TomKeddie/prj-kicad-libs/README.md

# tom-kicad

This is just a collection of my stuff I use in kicad, no warranty, use at own risk.
