TomKeddie/prj-kicad-libs/footprints/3dmodels/KaihlSocket_1511-CONN-170206_ASM_ASM_3_ASM__ASM.STEP

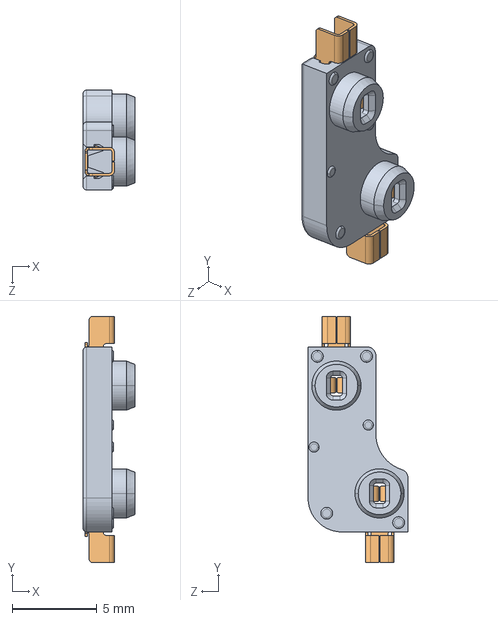
[picture p1: CAD file, 2021-04-25]
footprints/3dmodels/KaihlSocket_1511-CONN-170206_ASM_ASM_3_ASM__ASM.STEP
3.05 x 14.5 x 5.89 mm
BASE02_D6_18_18_1_1_1_1_2_1_1_2
CONN-011601_18_1_1_1_1_2_1_1_1 x 2
