TomKeddie/prj-kicad-libs/footprints/3dmodels/SMTSO-M3-10ET-PennEngineering-3D-05-29-2021.stp

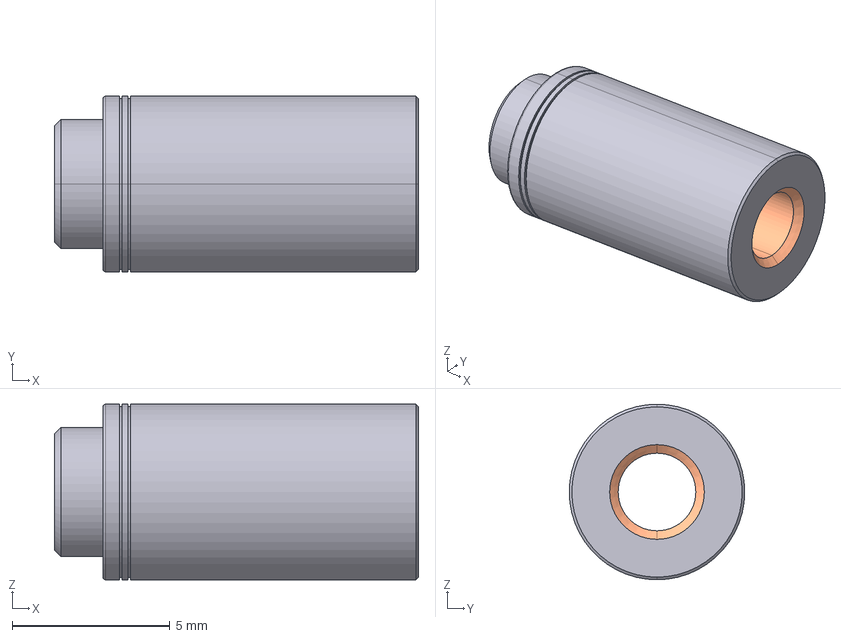
[picture p2: CAD file, 2021-05-30]
footprints/3dmodels/SMTSO-M3-10ET-PennEngineering-3D-05-29-2021.stp
11.5 x 5.56 x 5.56 mm
