TomKeddie/prj-kicad-libs/connectors/3d-models/FTSH-110-01-F-DV-K-TR--3DModel-STEP-56544.STEP

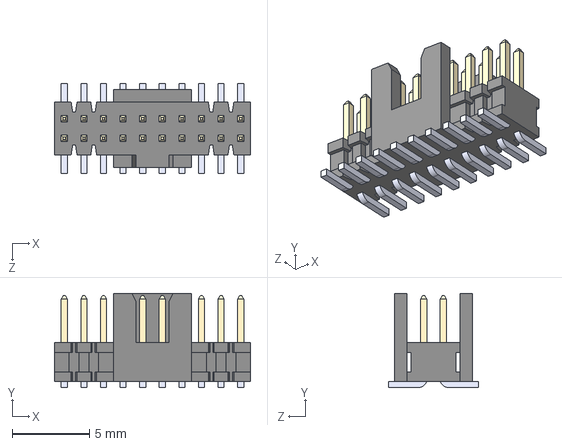
[picture p3: CAD file, 2022-05-18]
connectors/3d-models/FTSH-110-01-F-DV-K-TR--3DModel-STEP-56544.STEP
12.7 x 6.12 x 5.84 mm
