TomKeddie/prj-kicad-libs/footprints/3dmodels/1x1R4.step

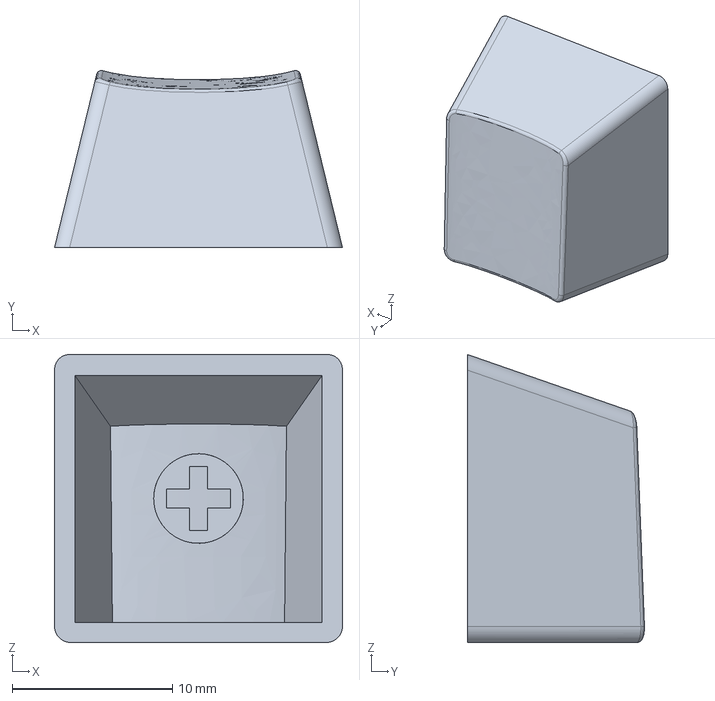
[picture p4: CAD file, 2021-04-25]
footprints/3dmodels/1x1R4.step
18.0 x 11.1 x 18.0 mm
