TomKeddie/prj-kicad-libs/footprints/3dmodels/mx_style_switch.stp

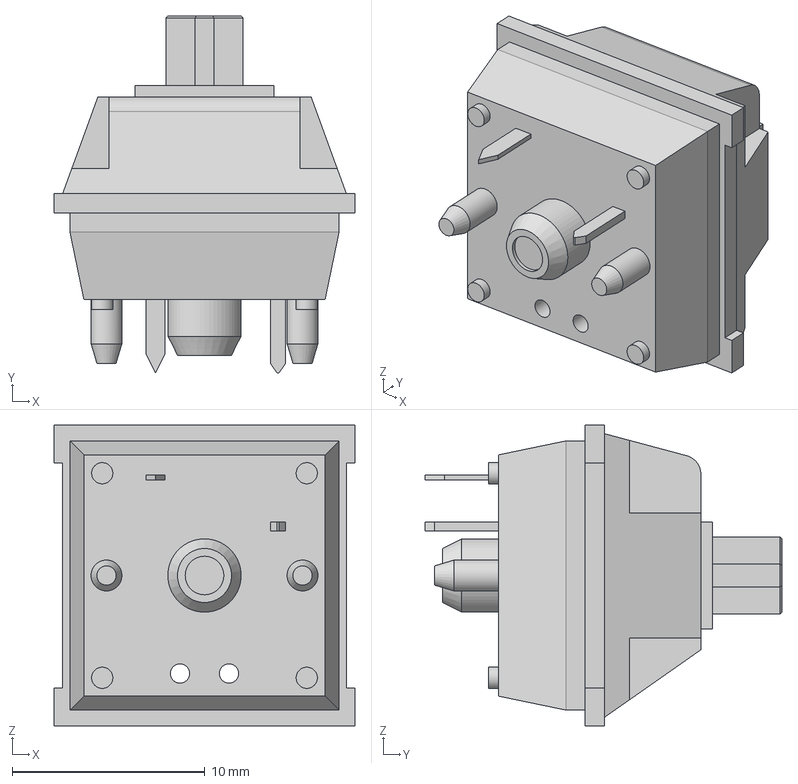
[picture p5: CAD file, 2021-04-21]
footprints/3dmodels/mx_style_switch.stp
15.6 x 18.5 x 15.6 mm
