TomKeddie/prj-kicad-libs/connectors/3d-models/pj-3200.stp

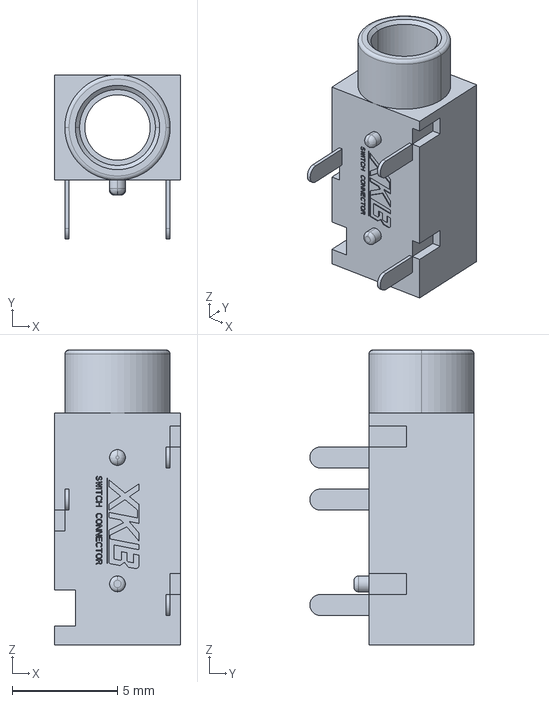
[picture p6: CAD file, 2022-05-16]
connectors/3d-models/pj-3200.stp
6.00 x 7.80 x 14.0 mm
