TomKeddie/prj-kicad-libs/footprints/3dmodels/FTSH-105-01-F-DV-K.stp

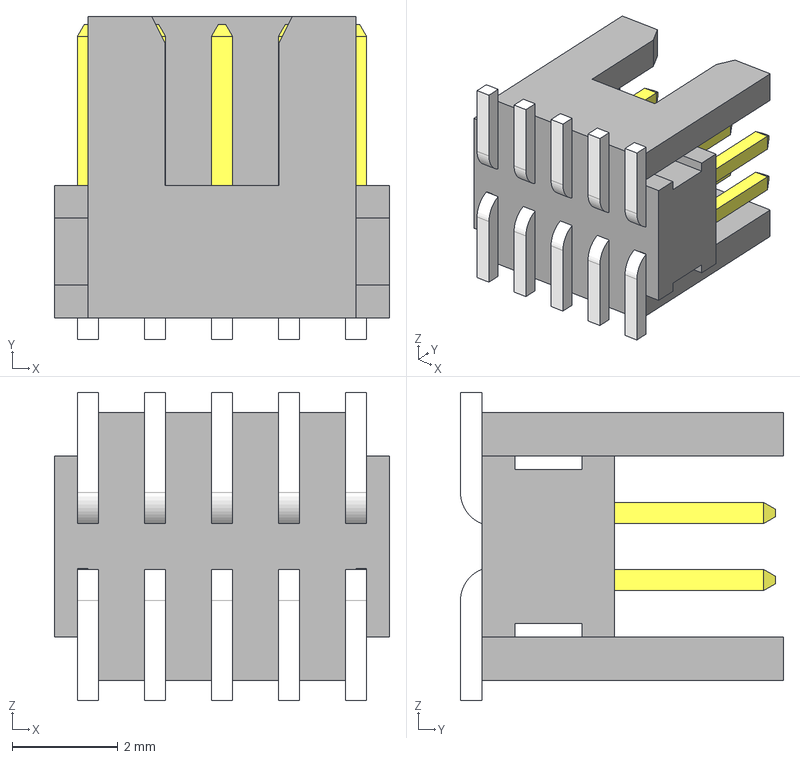
[picture p7: CAD file, 2021-03-10]
footprints/3dmodels/FTSH-105-01-F-DV-K.stp
6.35 x 6.12 x 5.84 mm
_FTSH-105-01-F-DV-K_body
_FTSH-105-01-F-DV-K_pins1
_FTSH-105-01-F-DV-K_pins2
