TomKeddie/prj-kicad-libs/footprints/3dmodels/FTSH-110-01-F-DV-K.stp

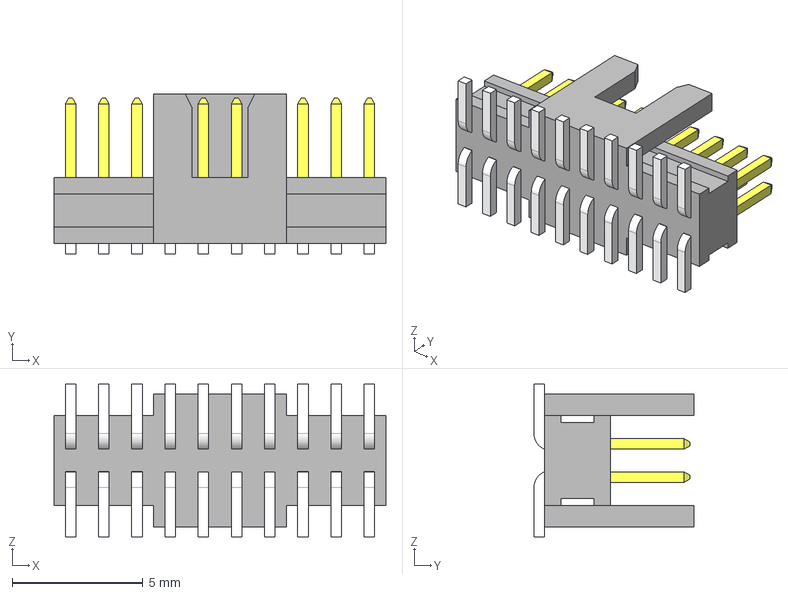
[picture p8: CAD file, 2021-03-10]
footprints/3dmodels/FTSH-110-01-F-DV-K.stp
12.7 x 6.12 x 5.84 mm
_FTSH-110-01-F-DV-K_body
_FTSH-110-01-F-DV-K_pins1
_FTSH-110-01-F-DV-K_pins2
