TomKeddie/prj-kicad-libs/connectors/3d-models/SSW-106-02-F-D-RA.stp

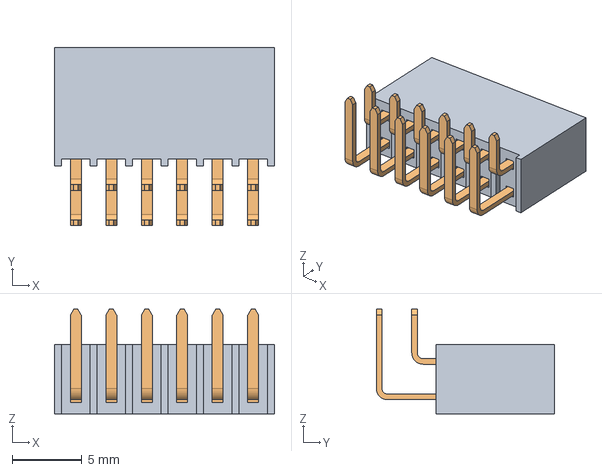
[picture p9: CAD file, 2021-12-23]
connectors/3d-models/SSW-106-02-F-D-RA.stp
15.7 x 12.8 x 7.48 mm
_T1SSW-106-02-F-D-RA
_P2SSW-106-02-F-D-RA
