TomKeddie/prj-kicad-libs/footprints/3dmodels/GT-USB-7010.step

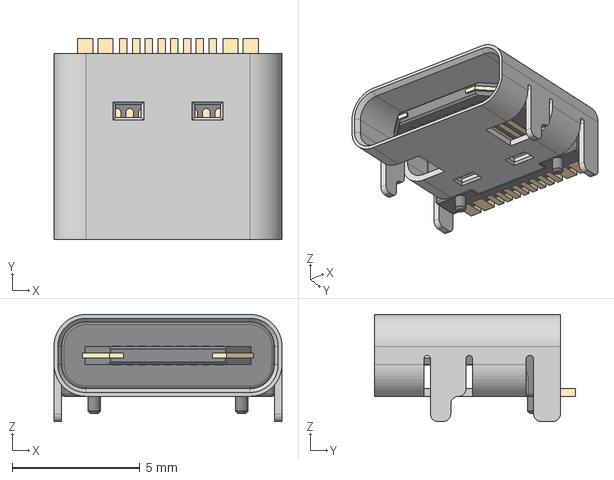
[picture p10: CAD file, 2020-12-16]
footprints/3dmodels/GT-USB-7010.step
8.94 x 7.90 x 4.20 mm
