TomKeddie/prj-kicad-libs/footprints/3dmodels/USB-A1HSW6--3DModel-STEP-56544.STEP

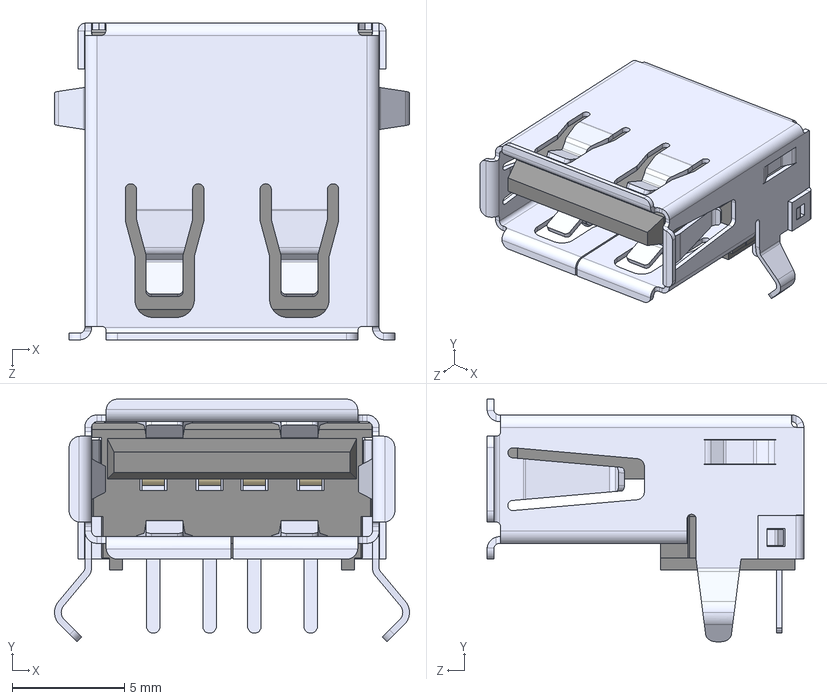
[picture p11: CAD file, 2020-09-19]
footprints/3dmodels/USB-A1HSW6--3DModel-STEP-56544.STEP
15.8 x 10.8 x 14.1 mm
