TomKeddie/prj-kicad-libs/footprints/3dmodels/CUI_DEVICES_UJ2-AV-1-TH.step

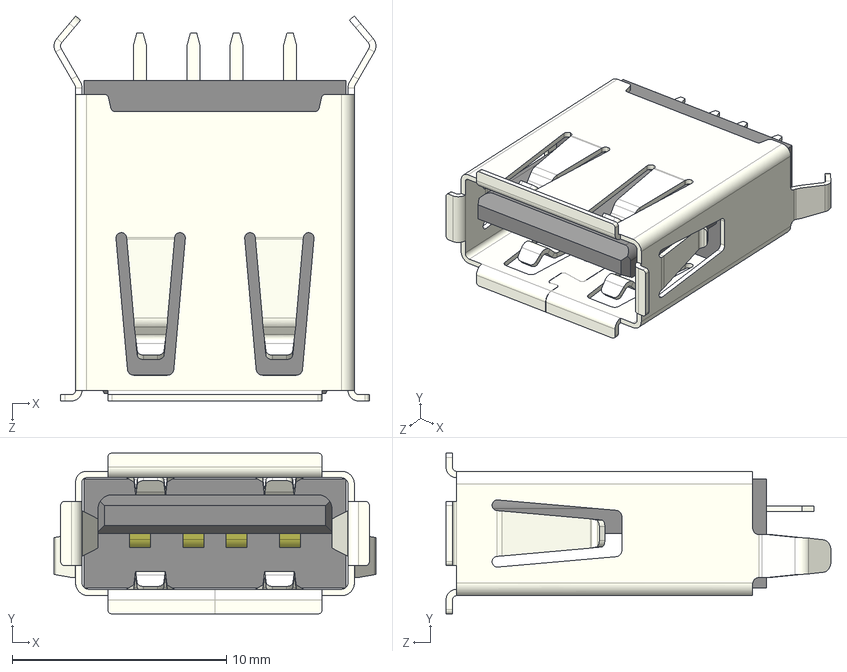
[picture p12: CAD file, 2020-09-19]
footprints/3dmodels/CUI_DEVICES_UJ2-AV-1-TH.step
15.0 x 7.50 x 18.0 mm
