TomKeddie/prj-kicad-libs/footprints/3dmodels/KMMX-BSMT35S-BTR_A.STEP

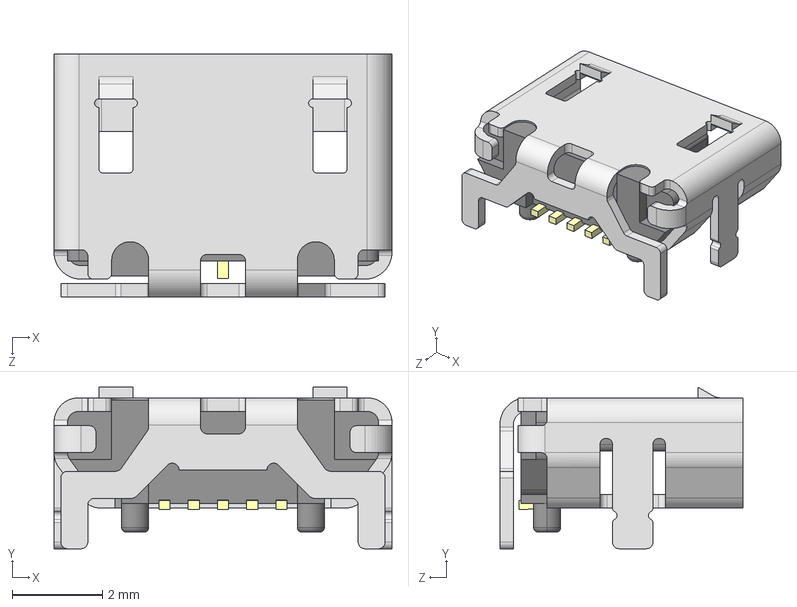
[picture p13: CAD file, 2020-09-19]
footprints/3dmodels/KMMX-BSMT35S-BTR_A.STEP
7.50 x 3.58 x 5.40 mm
