TomKeddie/prj-kicad-libs/footprints/3dmodels/mf-nsmf150.stp

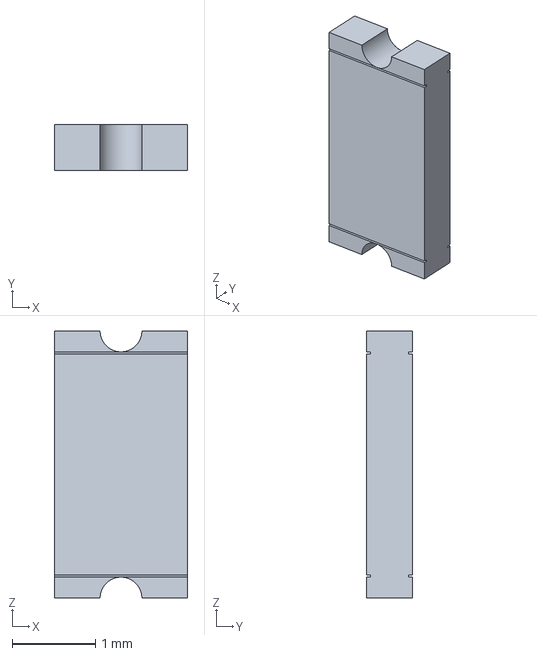
[picture p14: CAD file, 2020-09-19]
footprints/3dmodels/mf-nsmf150.stp
1.60 x 0.55 x 3.20 mm
