TomKeddie/prj-kicad-libs/footprints/3dmodels/cat_16-J8.stp

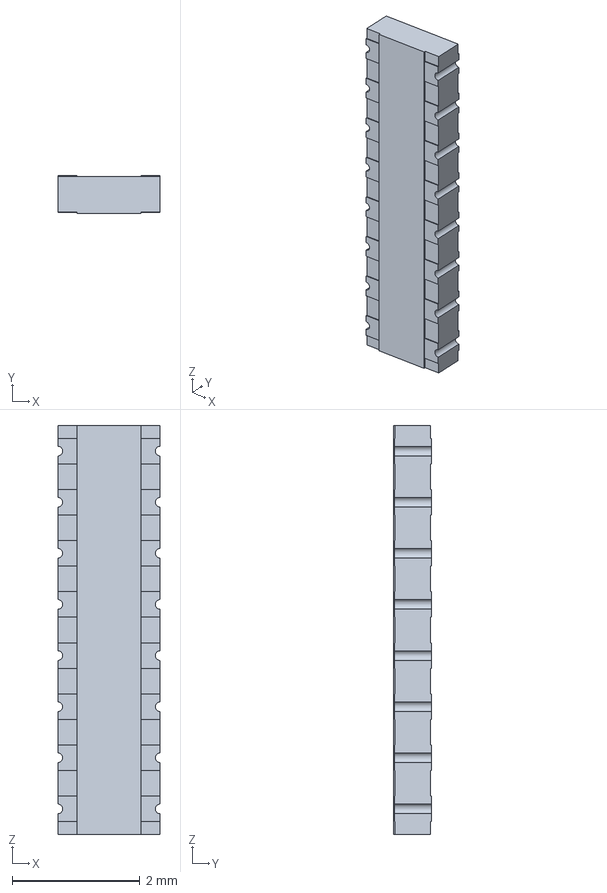
[picture p15: CAD file, 2020-04-07]
footprints/3dmodels/cat_16-J8.stp
1.60 x 0.6 x 6.40 mm
