TomKeddie/prj-kicad-libs/footprints/3dmodels/SSM-106-L-DV-A.stp

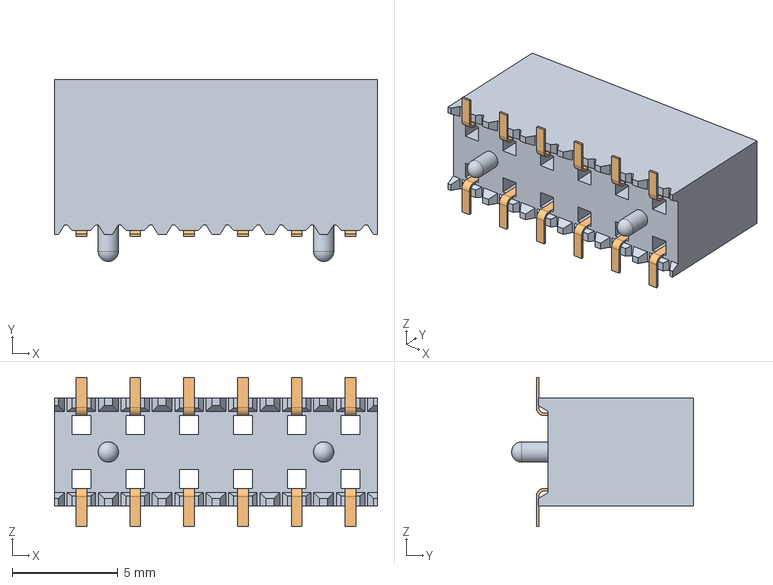
[picture p16: CAD file, 2019-11-22]
footprints/3dmodels/SSM-106-L-DV-A.stp
15.2 x 8.59 x 7.04 mm
_SSM-106-L-DV-A_body
_C-137-016
