TomKeddie/prj-kicad-libs/footprints/3dmodels/KMR621NG LFS--3DModel-STEP-56544.STEP

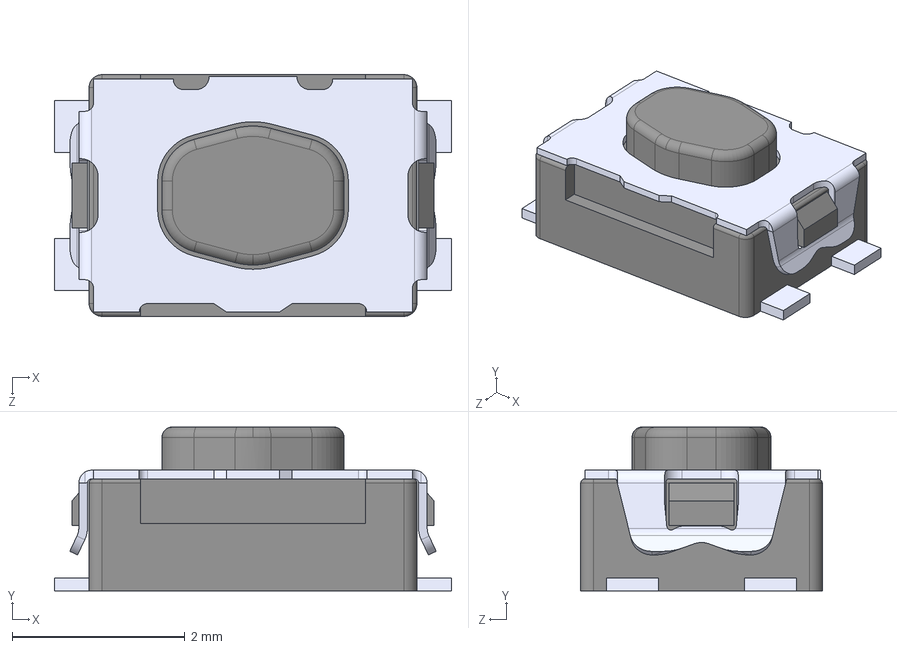
[picture p17: CAD file, 2019-11-22]
footprints/3dmodels/KMR621NG LFS--3DModel-STEP-56544.STEP
4.60 x 1.90 x 2.80 mm
