TomKeddie/prj-kicad-libs/footprints/3dmodels/SFH11-xxPC-D06-RA-BK.STEP

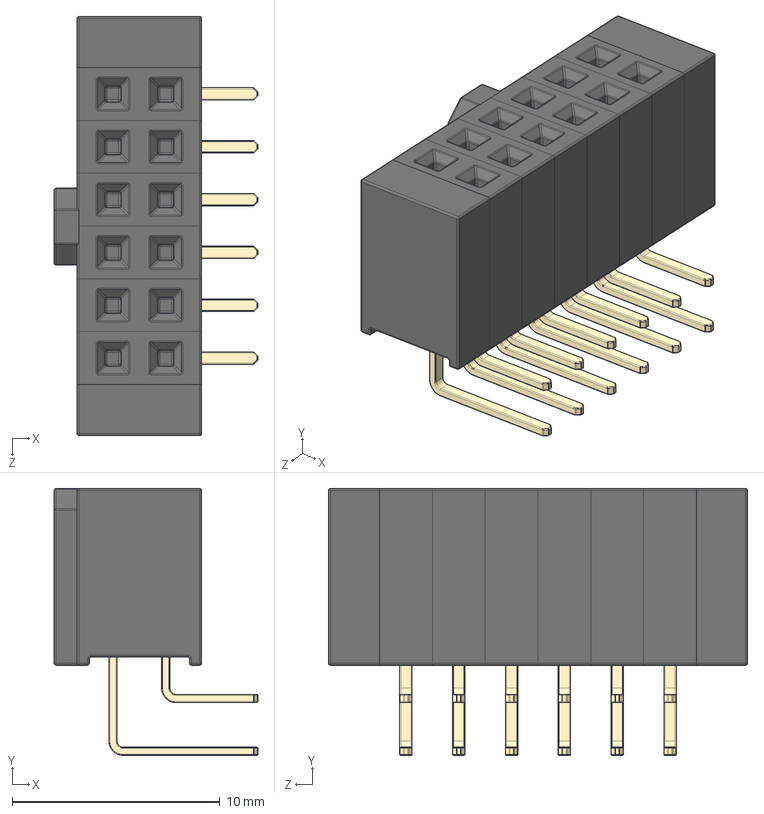
[picture p18: CAD file, 2019-10-13]
footprints/3dmodels/SFH11-xxPC-D06-RA-BK.STEP
9.80 x 12.8 x 20.2 mm
body section with RA gold pins x 6
end x 2
Polarizing Key
