TomKeddie/prj-kicad-libs/(list of files, cad)

Other CAD files:
connectors/3d-models/C-UTC009.step
connectors/3d-models/30306-5002.stp
connectors/3d-models/5788667-1--3DModel-STEP-1.STEP
connectors/3d-models/61201021721_Download_STP_61201021721_rev1.stp
connectors/3d-models/RJE0166001.step
footprints/3dmodels/480372200.stp
footprints/3dmodels/91618-310ALFc.stp
