TomKeddie/prj-kicad-libs/(commit log)

2015-04-09 Kicad usb sd card test board
2015-04-11 Updated USB schematic
2015-05-22 Add board edge usb connector imported from Digispark via https://github.com/DanChianucci/Eagle2Kicad
2015-05-22 Add USB mini connector symbol
2018-10-28 Import SMD PMOD connectors into kicad
2018-11-22 tom-connectors.pretty : add PMOD smd, add USB-C, add 1.27x5SWD
2018-12-05 kicad-connector/USB_C_Receptacle_GT-USB-7010 : change slots to Edge.Cuts outline instead of single line
2018-12-31 tom-connectors kicad lib - add usb-c 16pin - add pmod smd
2018-12-31 tom-semiconductors kicad lib - add ATSAMD21G18A-AU
2018-12-31 CONN_1.27_2x5.kicad_mod - fix pin numbering
2018-12-31 Add kicad footprints
2019-01-01 Added kicad libs for PTH plug and socket
2019-01-16 Added PTH PMOD footprints
2019-08-24 Restructure into symbols and footprints
2019-08-24 Add kicad mechanical library
2019-08-28 tom-connectors: add 1x6 pmod footprints in SMD and PTH
2019-10-11 tom-connectors : add USB_B_Micro
2019-10-11 tom-semiconductors.pretty : add BGA-24_5x5_6.0x8.0mm, LED_RGB_PLCC-6, SOIC-8_5.23x5.23mm_P1.27mm
2019-10-11 add tom-connectors.dcm
2019-10-13 tom-mechanical.pretty : add SolderJumper-2_P1.3mm
2019-10-13 Added kicad gitignore
2019-10-13 tom-connectors.pretty : Add 3d model to PMOD_2X6_PTH_RA_SOCKET
    [SFH11-xxPC-D06-RA-BK.STEP]
2019-11-09 footprints/tom-passives: add 0603 cap
2019-11-16 tom-connectors: remove power desingation from pmod pins, add 1x9, 2x20 connectors
2019-11-16 footprints/tom-connectors: add JST-2mm, add mirrored 2.54mm header
2019-11-19 tom-connectors: add 1x9 2.54mm header tom-opto: new lib with smd 7 segment displays
2019-11-19 tom-passives: add 0603 resistor tom-opto: update the footprint
2019-11-20 tom-connectors: increase pad sizes on 2X6_SMD_RA_SOCKET
2019-11-21 tom-connectors: remove silk board edge from pmods tom-mechanical: add spst switch
2019-11-21 tom-opto: move leds from tom-semiconductors, add XZM2CYK45WT-9-NOMASK
2019-11-21 tom-connectors: add SAO tom-opto: move more leds from semiconductors
2019-11-22 tom-connectors: Add SAO connector add 3d models
    [KMR621NG LFS--3DModel-STEP-56544.STEP, SSM-106-L-DV-A.stp]
2019-11-29 tom-connectors/tom-mechanical: new footprints for glasgos pmod
2019-12-13 tom-connectors: add 1x6 male pmod
2020-02-02 tom-connectors lib: Added Conn_02x08_Odd_Even
2020-02-02 tom-connectors/tom-mechanical footprints : added castellation, solderjumpers, pinsocket
2020-02-05 tom-passives.pretty: add C_0402_1005Metric.kicad_mod tom-semiconductors.pretty : add SSOP-16_3.9x4.9mm_P0.635mm.kicad_mod
2020-03-03 tom-connectors: add 02x20_Odd_Even-Connector_Generic, Conn_02x20_Odd_Even, Conn_01x06
2020-03-10 footprints/tom-modules: add APXS006.kicad_mod
2020-03-15 footprints: add various footprints for artix7-pcie project
2020-03-15 tom-semiconductors: add misc diode symbols
2020-03-20 tom-modules : add TPS82130SILT tom-passive : add 4 pin 3225 crystal
2020-03-22 tom-passives: add gnd pins to 4 pin xtal
2020-03-22 tom-connectors: add USB3_A_AS_PCIE footprint
2020-04-07 tom-opto: add SLD161616DRA2B led matrix
2020-04-07 tom-opto: fix pin spacing in 16x16 matrix
2020-04-07 tom-passive:add R_PACK8_CAT16J8 tom-semitconductors: add SOIC-16 and SSOP-16
    [cat_16-J8.stp]
2020-04-09 tom-connectors:PinSocket_2x08_P2.54mm change pads to oval
2020-04-19 tom-passives: add NoPaste versions of 0402/0603 tom-connectors: fix micro usb mounting pads
2020-04-19 tom-mechanical : add mounting holes
2020-05-24 tom-passives: add R_1OF2, single resistor with two load options
2020-05-26 tom-connectors: add Conn_02x22_Odd_Even symbol for glasgow
2020-05-26 tom-passives: add 1 of 2 resistor footprint
2020-08-09 tom-opto: add 0805 led with T marking
2020-08-09 tom-passives: add polarised 1206 Cap tom-mechancial: add aliexpress smd button
2020-09-02 tom-passives: add Sunlord MWSA0518S footprint
2020-09-02 tom-opto: add 0402/0603 leds tom-mechanical: add jlcpcb assembly tool holes
2020-09-13 tom-passives: add 3528 cap footprint, remove silk from inductor footprint
2020-09-19 Add usb connectors w/models, add basic leds
    [CUI_DEVICES_UJ2-AV-1-TH.step, KMMX-BSMT35S-BTR_A.STEP, USB-A1HSW6--3DModel-STEP-56544.STEP, mf-nsmf150.stp]
2020-10-10 Footprints Add 1206 led Add 5.08mm 1x4 connector Add 0805/1206 resistors Add 5032 Crystal Add QFN44 for atmega 32u4 Add SOT-23 for fets Add dip-8
2020-10-14 tom-connectors: Changed footprint for inverted connectors
2020-11-26 tom-connectors: add PinTestpoint_2x03_P2.54mm tom-semiconductors: add SOT23_NXP
2020-11-27 tom-connectors: add swd connector tom-mechanical: add dpdt switch
2020-11-29 tom-connectors : add 2x5 1.27mm connectors
2020-12-08 tom-opto: add B1010RGBT 1mmx1mm rgb led
2020-12-08 tom-semiconductors: fix footprint reference
2020-12-13 tom-opto: add footprint for side lit led
2020-12-13 tom-passives: add eco1 layer to 1206 passive for laser cutting
2020-12-13 tom-connectors: add Badgelife-SAOv169-SAO footprints
2020-12-13 tom-connectors: add Badgelife-SAOv169-SAO symbol
2020-12-16 tom-connectors: add SWD tom-passives: add LCSC fields to R & C
    [GT-USB-7010.step]
2020-12-16 tom-connectors: enlarge pads on connectors
2021-01-04 tom-connectors: add Molex 480372200 USB A plug
    [480372200.stp]
2021-01-13 Misc footprint updates
2021-01-14 tom-connectors: add USB C connectors and M.2
2021-01-14 tom-semiconductors: add more lcsc regulators
2021-01-14 Add footprints for cle215 carrier
2021-01-15 tom-connectors: reduce size of inside pads on PinSocket_2x05_P1.27mm_Vertical
2021-01-23 tom-connectors: add 2x3 and 2x5 2.54mm connectors
2021-02-02 tom-connectors: add stemma/qwiic connector
2021-02-02 Add misc footprints
2021-02-26 Updated to modules, semicondutors, connectors
2021-03-10 tom-connectors: add 2x10 connectors
    [91618-310ALFc.stp, FTSH-105-01-F-DV-K.stp, FTSH-110-01-F-DV-K.stp]
2021-03-12 tom-connectors: add 2x10 2.54mm connectors
2021-04-19 tom-connectors: remove label_silk as it is kicad 5.99
2021-04-19 tom-connectors: add various 1.27mm and 2.54mm headers
2021-04-19 tom-connectors: add M3 stud
2021-04-21 tom-modules: fix suspend pin numbering on ft4232 module
2021-04-21 tom-mechanical: add KailhClip and 3d models
    [mx_style_switch.stp]
2021-04-25 Misc updates for keypad
    [1x1R4.step, KaihlSocket_1511-CONN-170206_ASM_ASM_3_ASM__ASM.STEP]
2021-05-30 tom-mechanical: add M3 solder studs
    [SMTSO-M3-10ET-PennEngineering-3D-05-29-2021.stp]
2021-12-23 Restructure for kicad 6 - convert all symbols to new format, organise per type
    [5788667-1--3DModel-STEP-1.STEP, SSW-106-02-F-D-RA.stp]
2022-01-22 connectors: add UTC009 USB plug from SolderParty
    [C-UTC009.step]
2022-01-22 mechanical: add symbol and footprint for SMD NC button
2022-01-22 modules: add micromod function board
2022-05-16 tom-connectors: misc updates
    [955016669.stp, pj-3200.stp]
2022-05-18 tom-connectors: add RJ12, RJ45 & 20 pin 1.27mm samtec
    [955016669.stp, FTSH-110-01-F-DV-K-TR--3DModel-STEP-56544.STEP, RJE0166001.step]
2022-05-18 tom-connectors: updates for tag connect breakout
    [30306-5002.stp, 61201021721_Download_STP_61201021721_rev1.stp]
2022-08-25 semiconductors: add RP2040 cpu symbol and footprint
2024-01-01 opto: updates for parts used in 2023 process pcb
2024-01-01 connectors: updates for parts used in process pcb
2024-01-01 Misc updates for parts used in process pcb
