TomKeddie/prj-kicad-libs/(notices)

Notices in the files:
footprints/3dmodels/FTSH-110-01-F-DV-K.stp:
FILE_NAME( 'e:/temp/worker_4/temp/exporttempdir_2628_194_0CWaT/format_0/FTSH-110-01-F-DV-K.stp', '2021-02-26T20:27:53', ( 'License CC BY-ND 4.0' ), ( 'CADENAS' ), ' ', 'PARTsolutions', ' ' );
footprints/3dmodels/FTSH-105-01-F-DV-K.stp:
FILE_NAME( 'e:/temp/worker_4/temp/exporttempdir_888_377_5tQi2/format_0/FTSH-105-01-F-DV-K.stp', '2021-02-19T00:26:35', ( 'License CC BY-ND 4.0' ), ( 'CADENAS' ), ' ', 'PARTsolutions', ' ' );
connectors/3d-models/SSW-106-02-F-D-RA.stp:
FILE_NAME( 'e:/temp/worker_230/temp/exporttempdir_4636_166_XmPFY/format_0/SSW-106-02-F-D-RA.stp', '2021-12-23T05:01:08', ( 'License CC BY-ND 4.0' ), ( 'CADENAS' ), ' ', 'PARTsolutions', ' ' );
